adamforbes92/PWM_FanControl/hardware/BOM_Board1_Schematic1_2026-09-06.xlsx

No. | Quantity | Comment | Designator | Footprint | Value | Manufacturer Part | Manufacturer | Supplier Part | Supplier
1 | 1 | 1uF | C1 | C0805 | 1uF | GCM21BR7YA105KA55L | muRata(村田) | C161268 | LCSC
2 | 1 | 10uF | C2 | C0805 | 10uF | GRM21BC8YA106KE11L | muRata(村田) | C469541 | LCSC
3 | 4 | 680uF | C3,C4,C5,C6 | CAP-SMD_BD10.0-L10.3-W10.3-FD-LS11.0_H12.0 | 680uF | MA35V680M10X13 | JIERR(捷而瑞) | C48971043 | LCSC
4 | 1 | 4.7nF | C7 | C0603 | 4.7nF | CC0603JRNPO9BN472 | YAGEO(国巨) | C576818 | LCSC
5 | 2 | 1uF | C8,C12 | C0603 | 1uF | HGC0603R7105K250NTHJ | Chinocera(华瓷) | C33546005 | LCSC
6 | 1 | 100uF | C9 | C1206 | 100uF | CL31A107MQHNNNE | SAMSUNG(三星) | C15008 | LCSC
7 | 1 | 1uF | C10 | C0603 | 1uF | CGA3E1X7R1V105KT000N | TDK | C342956 | LCSC
8 | 1 | 4.7uF | C11 | C0603 | 4.7uF | EMK107ABJ475KA-T | TAIYO YUDEN(太诱) | C92758 | LCSC
9 | 1 | 10kΩ | CALIBRATION | RES-ADJ-TH_3362P | 10kΩ | 3362P-1-103 | BOCHEN(博晨) | C118956 | LCSC
10 | 2 | 1N4148WS | D1,D3 | SOD-323_L1.8-W1.3-LS2.5-RD |  | 1N4148WS | JSMSEMI(杰盛微) | C917117 | LCSC
11 | 1 | SMCJ16A | D2 | SMC_L7.1-W6.2-LS8.1-R-RD |  | SMCJ16A | RUILON(瑞隆源) | C10249 | LCSC
12 | 1 | MBR60100DC | D4 | TO-263-3_L10.2-W9.0-P5.08-LS15.2-BR |  | MBR60100DC | YFW(佑风微) | C6069541 | LCSC
13 | 1 | BX-XH2.54-2PZZ | EXT_CNTL | CONN-TH_2P-P2.50_BX-XH2.54-2PZZ |  | BX-XH2.54-2PZZ | Bossie(博锡) | C18077833 | LCSC
14 | 1 | PZ254V-11-02P | EXT_CNTL_JMP | HDR-TH_2P-P2.54-V-M |  | PZ254V-11-02P | XFCN(兴飞) | C492401 | LCSC
15 | 1 | XL-1608SURC-06 | FULL | LED0603-RD_RED |  | XL-1608SURC-06 | XINGLIGHT(成兴光) | C965799 | LCSC
16 | 1 | XL-1608UGC-04 | PWM | LED0603-RD_GREEN |  | XL-1608UGC-04 | XINGLIGHT(成兴光) | C965804 | LCSC
17 | 3 | 120P03 | Q1,Q2,Q3 | TO-252-2_L6.6-W6.1-P4.57-LS9.9-BR-CW |  | 120P03 | HL(富海微) | C20071222 | LCSC
18 | 1 | 2N7002 | Q4 | SOT-23-3_L2.9-W1.3-P1.90-LS2.4-BR |  | 2N7002 | JSMSEMI(杰盛微) | C916396 | LCSC
19 | 2 | 1kΩ | R1,R5 | R0603 | 1kΩ | 0603WAF1001T5E | UNI-ROYAL(厚声) | C21190 | LCSC
20 | 5 | 10kΩ | R2,R3,R4,R7,R12 | R0603 | 10kΩ | 0603WAF1002T5E | UNI-ROYAL(厚声) | C25804 | LCSC
21 | 1 | 0Ω | R6 | R1210 | 0Ω | FRC1210F0000TS | FOJAN(富捷) | C2974058 | LCSC
22 | 3 | 10Ω | R8,R9,R11 | R0805 | 10Ω | AS05W2J0100T5E | UNI-ROYAL(厚声) | C966152 | LCSC
23 | 1 | 1kΩ | R10 | R1210 | 1kΩ | FRC1210J102TS | FOJAN(富捷) | C2930439 | LCSC
24 | 5 | Test-Point | TP_GATE,TP_SG1,TP_SG2,TP_SG3,TP_TC | Test-Point-0.5mm
25 | 1 | SG3525AP013TR | U1 | SOIC-16_L9.9-W3.9-P1.27-LS6.0-BL |  | SG3525AP013TR | ST(意法半导体) | C68323 | LCSC
26 | 1 | TC4420EOA713 | U2 | SOIC-8_L5.0-W4.0-P1.27-LS6.0-BL |  | TC4420EOA713 | MICROCHIP(美国微芯) | C231865 | LCSC
