adamforbes92/PWM_FanControl/hardware/SCH_Schematic1_2026-09-06.pdf

# POTPOT

# Add zener to protect 12v on triggers

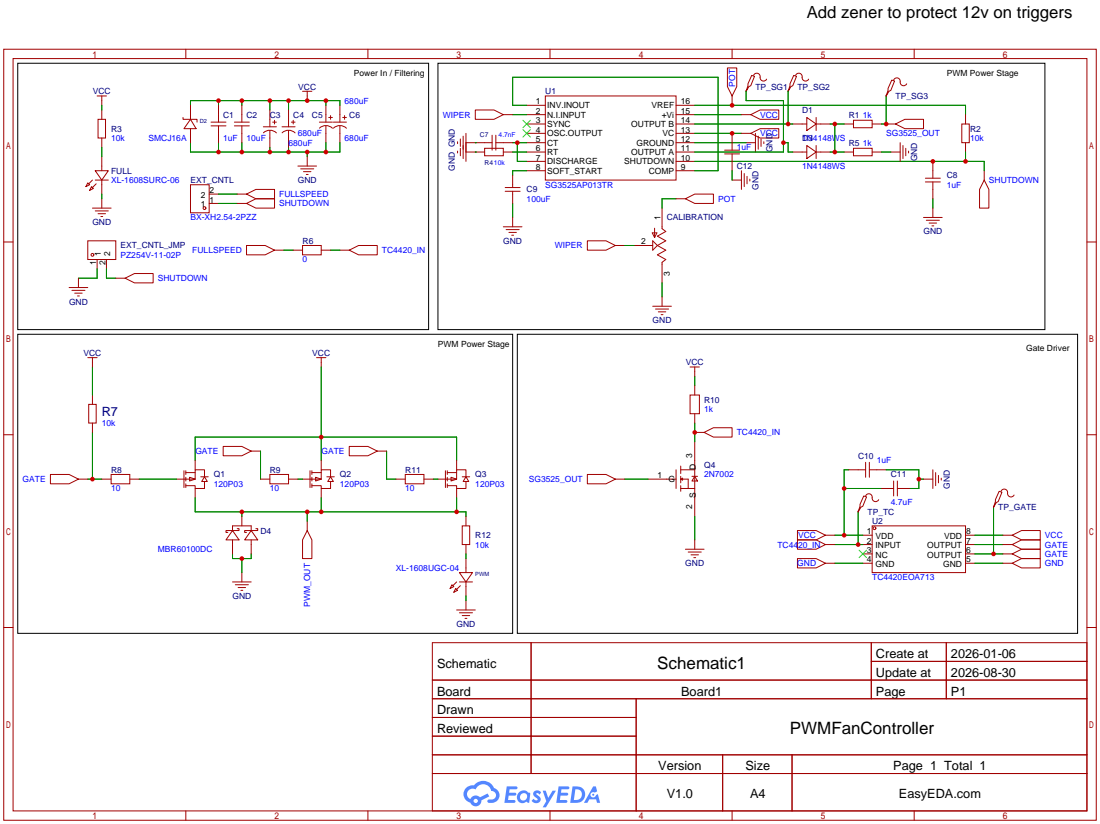
[picture p3: page 1]

SHUTDOWN 10 OUTPUT A 11 GROUND 12 VC 13 OUTPUT B 14 +Vi 15 VREF 16

Schematic | Schematic1 | Create at | 2026-01-06

Update at | 2026-08-30

Board | Board1 | Page | P1
Drawn | | PWMFanController
Reviewed

Version | Size | Page 1 Total 1
V1.0 | A4 | EasyEDA.com
