adamforbes92/PWM_FanControl/(list of files, drawings)

Other design files:
hardware/PWM_FanControl.easyeda.json
hardware/PWMFanController.epro
