adamforbes92/PWM_FanControl/(commit log)

2026-06-22 Add 555 PWM high-side fan controller schematic, netlist, BOM and docs
    - EasyEDA-importable schematic JSON (12V automotive, 300W/25A, high-side P-ch)
    - 4x parallel 40V P-FETs (heatsink-free), push-pull gate drive
    - RESET-based enable (pin1 permanently grounded), full-speed interlock
    - 3-pin mode header (Option 1: pin1=full speed, pin2=PWM)
    - Inrush (NTC+bypass), reverse-batt ideal diode, load-dump TVS, bulk caps
    - Flyback + RC snubber, gate Vgs clamp + fail-safe pulldown
    - Human-readable netlist, CSV BOM, and design notes
2026-06-22 Make TC4420 the default gate driver (option B); demote discrete totem pole to DNF; remove stale QFRC netlist line
    [BOM.csv, PWM_FanControl.easyeda.json]
2026-06-22 Fix review comments: correct Q_n pin mapping, clarify Q_lvl/R_b1 DNF notes, fix lvlout comment in netlist
    [BOM.csv, PWM_FanControl.easyeda.json]
2026-06-22 Add PWM fan control netlist
    This file contains the netlist for the PWM fan control circuit, including components and their connections.
